Awesome-Toys/AT-DX1/THIRD_PARTY.md

# Third-party material

AT-DX1 references and depends on third-party projects. Their names, code and documentation remain subject to the terms supplied by their respective authors.

The current firmware includes headers/APIs from:

- **Arduino / Arduino-Pico core** (Earle Philhower RP2040/RP2350 Arduino core)
- **Adafruit TinyUSB**
- **Arduino Audio Tools**
- Raspberry Pi Pico SDK headers exposed by the Arduino-Pico build environment

The repository does not attempt to relicense those projects.

## TinyDX / WB2CBA

AT-DX1 acknowledges TinyDX and WB2CBA as described in `ACKNOWLEDGEMENTS.md`. The AT-DX1 licences apply to original AT-DX1 material only. If any source copied from an upstream project is added or identified, its original copyright and licence notice must be retained and documented here.
