Awesome-Toys/AT-DX1/docs/images/at-dx1-cw-app-screenshot.jpg

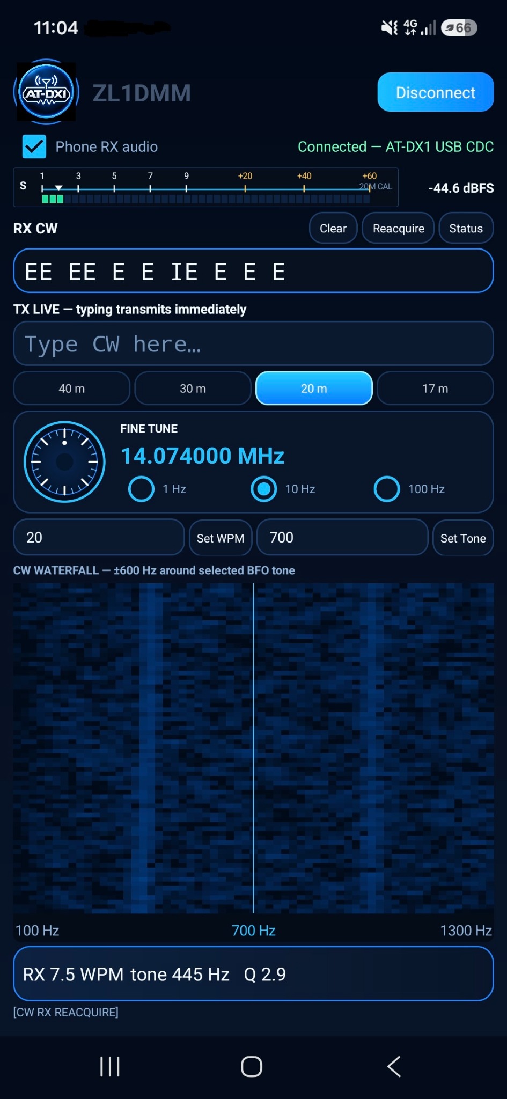
docs/images/at-dx1-cw-app-screenshot.jpg
