Awesome-Toys/AT-DX1/(commit log)

2026-09-14 Initial AT-DX1 open hardware release
    [AT-DX1_BOM_RP2354A_2026-09-14.csv, BOM_FT8-FT4_RP2354A_2026-09-14_EasyEDA-export.csv]
2026-09-14 Update README.md
    Added prototype with phone
2026-09-16 Update AT-DX1 docs for I/Q RX, calibration and centred CW
2026-09-16 Fix current firmware and Android app paths
2026-09-16 Document exact Arduino IDE build settings for RP2354A
